PeterkalM/RollerBlinds/board/schematic.pdf

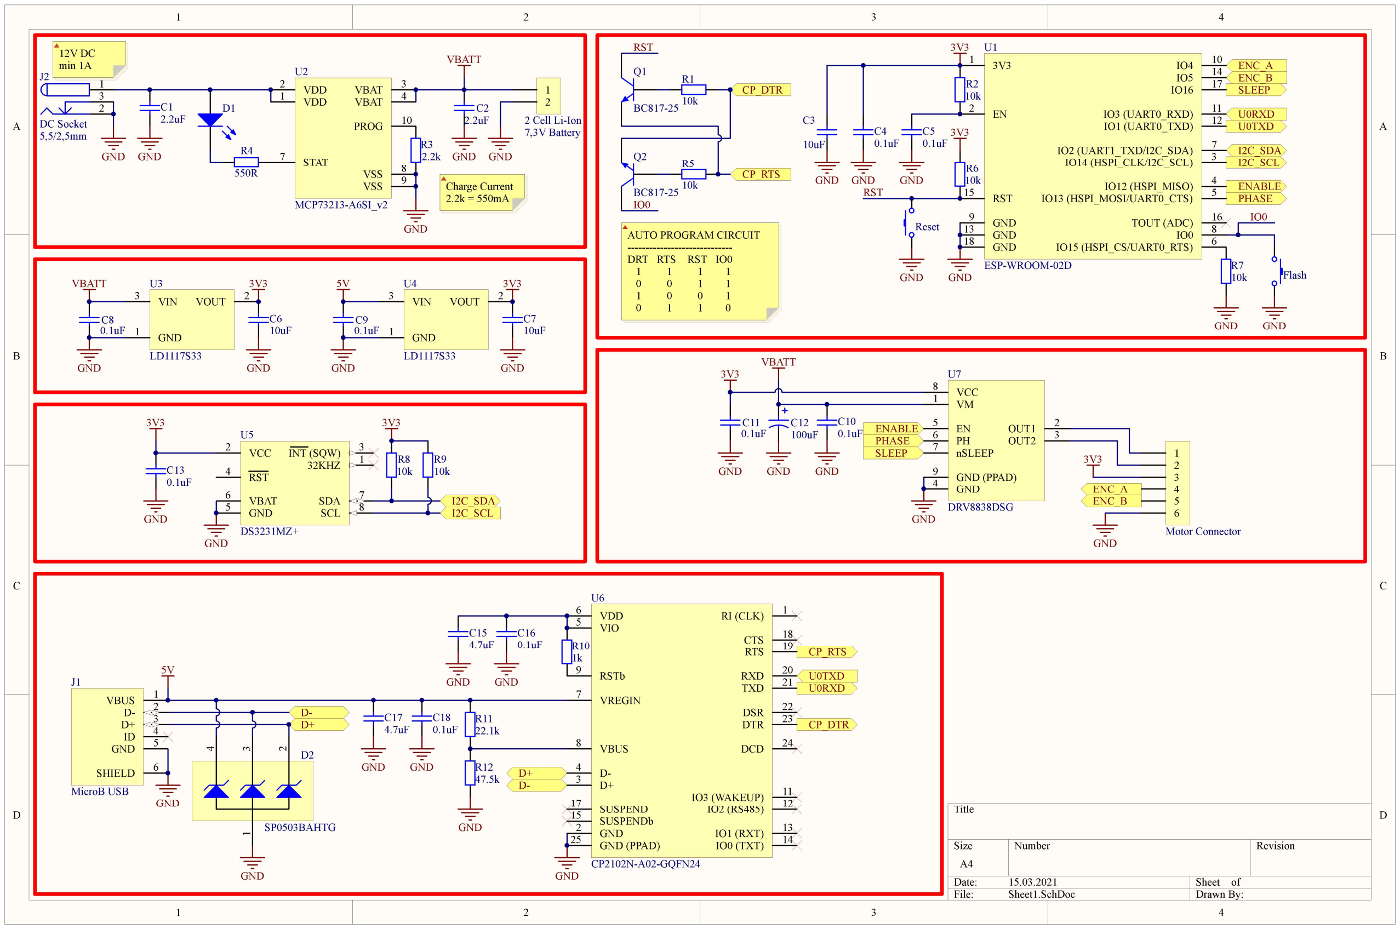
[picture p1: page 1]

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
Title

Size | Number | Revision
A4
Date: | 15.03.2021 | Sheet of
File: | Sheet1.SchDoc | Drawn By:

C3

10uF

C4
0.1uF

3V3

R2
10k

C5
0.1uF

GND

U0RXD
U0TXD

I2C_SDA
I2C_SCL

R7
10k

GND C8
0.1uF

C6
10uF

3V3

GND

C10
0.1uF ENABLE
PHASE
SLEEP | 3V3
| ENC_A
| ENC_B

GND

3V3

I2C_SDA
I2C_SCL

R9
10k

R8
10k

GND

3V3

ENABLE
PHASE

SLEEP

ENC_A
ENC_B

GND

C15
4.7uF

C16
0.1uF

GND

GND

GND

GND GND

GND GND

GND

GND | GND

GND

R10
1k

R11
22.1k

R12
47.5k

GND

D+
D-

C17
4.7uF

C18
0.1uF

GND GND

GND

D+

D-

GND

VBATT

CP_RTS

U0RXD

U0TXD

CP_DTR

R1

10k

R5

10k

3V3

VBATT

R6
10k

3V3

GND

5V

C9
0.1uF

C7
10uF

3V3

GND | GND

5V

C13
0.1uF
GND | R4
| 550R

C1
2.2uF

GND

C2
2.2uF

R3
2.2k

GND

GND GND

VBATT

1
2

7,3V Battery

### 2 Cell Li-Ion

CP_RTS

CP_DTR

32KHZ 1

VCC 2

INT (SQW) 3

RST 4

GND 5

VBAT 6 | SDA | 7
| SCL | 8

U5

DS3231MZ+

C11
0.1uF

GND

C12
100uF

D1

Flash

Reset

Q2

BC817-25

Q1

BC817-25

1
2
3
4
5
6
Motor Connector

IO0

RST

IO0

RST

VBUS | 1
D- | 2
D+ | 3
ID | 4
GND | 5
SHIELD | 6

J1

MicroB USB | 1

4

| 3

2
D2

SP0503BAHTG

VM 1

OUT1 | 2
OUT2 | 3

GND 4

EN 5
PH 6
nSLEEP 7

VCC 8

GND (PPAD) 9

U7

DRV8838DSG

VDD 2
VDD 1

STAT 7

VBAT | 3
VBAT | 4
PROG | 10
VSS | 8
VSS | 9

U2

MCP73213-A6SI_v2

RI (CLK) 1

GND 2

D+ 3

D- 4

VIO 5

VDD 6

VREGIN 7

VBUS 8

RSTb 9

IO3 (WAKEUP) | 11
IO2 (RS485) | 12
IO1 (RXT) | 13
IO0 (TXT) | 14

SUSPENDb 15

CTS | 18
RTS | 19
RXD | 20

SUSPEND 17

TXD | 21
DSR | 22
DTR | 23
DCD | 24

GND (PPAD) 25

U6

CP2102N-A02-GQFN24

3V3 1

EN 2

IO14 (HSPI_CLK/I2C_SCL) | 3
IO12 (HSPI_MISO) | 4
IO13 (HSPI_MOSI/UART0_CTS) | 5
IO15 (HSPI_CS/UART0_RTS) | 6
IO2 (UART1_TXD/I2C_SDA) | 7
IO0 | 8

GND 9

IO4 | 10
IO3 (UART0_RXD) | 11
IO1 (UART0_TXD) | 12

GND 13

IO5 14

RST 15

TOUT (ADC) | 16
IO16 | 17

GND 18

U1

ESP-WROOM-02D

1

2

3

5,5/2,5mm

J2

DC Socket

VOUT 2

GND 1

VIN 3

U3

LD1117S33

VOUT 2

GND 1

VIN 3

U4

LD1117S33

12V DC
min 1A

Charge Current
2.2k = 550mA

AUTO PROGRAM CIRCUIT
DRT RTS RST IO0
1 | 1 | 1 | 1
0 | 0 | 1 | 1
1 | 0 | 0 | 1
0 | 1 | 1 | 0
