PeterkalM/RollerBlinds/3D files/ruloo_assembly.SLDASM

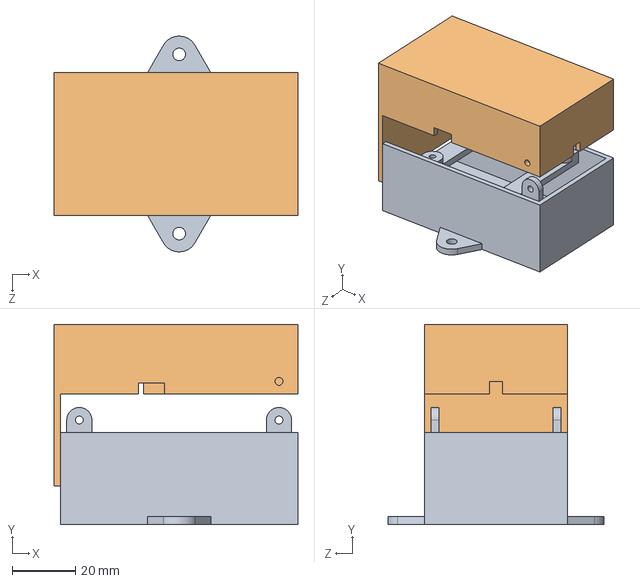
[picture p2: CAD file, 2021-03-15]
3D files/ruloo_assembly.SLDASM
77.0 x 63.2 x 68.1 mm
Karp
Kaas
