PeterkalM/RollerBlinds/3D files/micro-metal-gearmotor-bracket.step

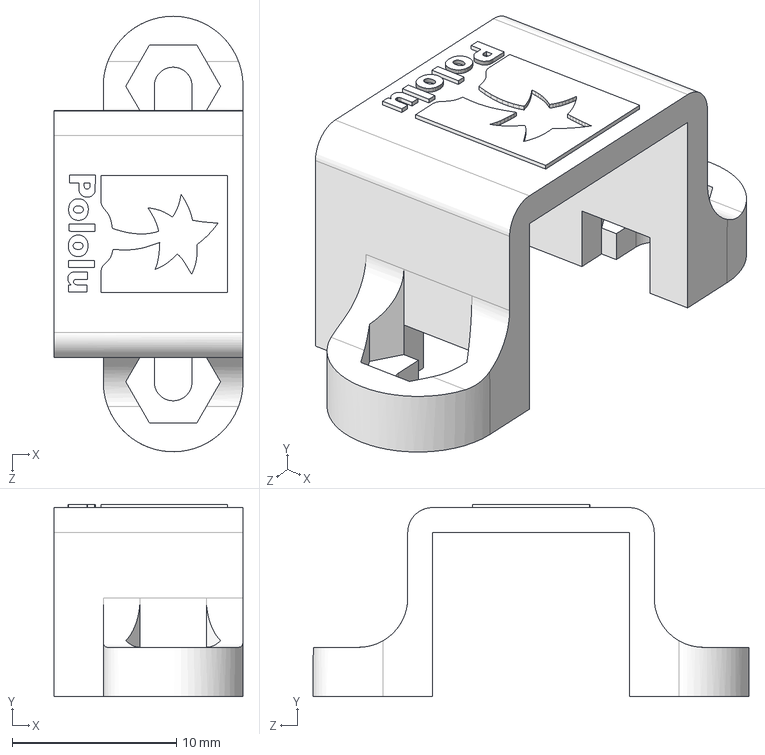
[picture p3: CAD file, 2021-03-15]
3D files/micro-metal-gearmotor-bracket.step
11.5 x 11.7 x 26.5 mm
