PeterkalM/RollerBlinds/3D files/ruloo_spinner.SLDPRT

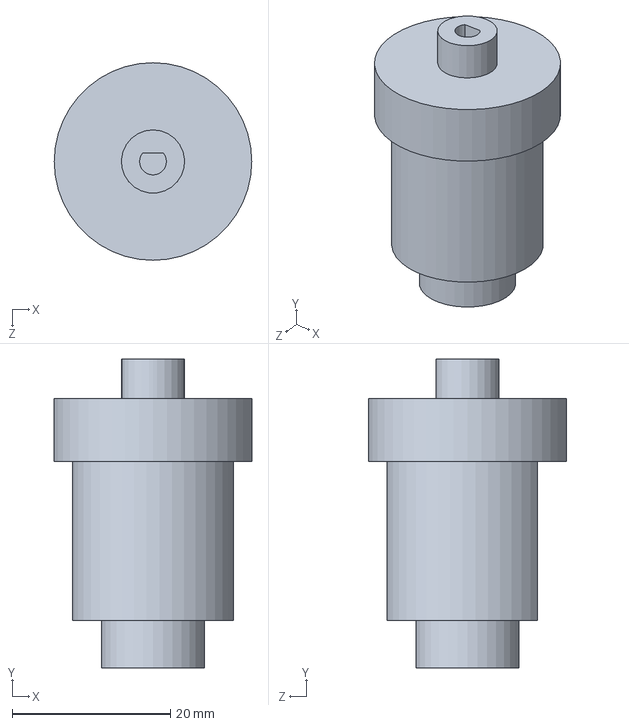
[picture p4: CAD file, 2021-03-15]
3D files/ruloo_spinner.SLDPRT
25.0 x 39.1 x 25.0 mm
