PeterkalM/RollerBlinds/3D files/ruloo_lid.SLDPRT

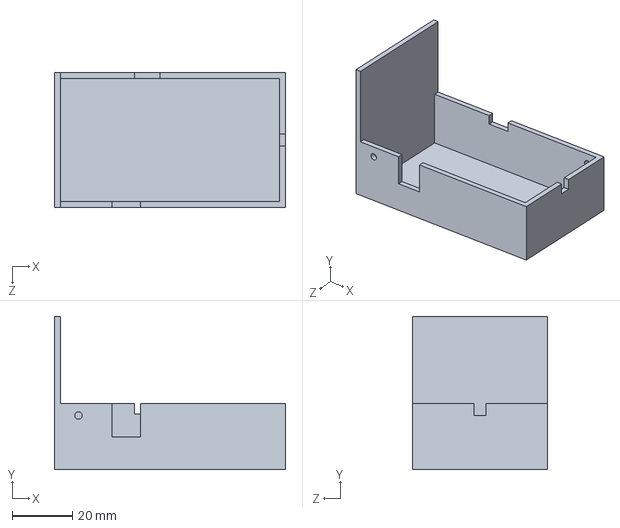
[picture p5: CAD file, 2021-03-15]
3D files/ruloo_lid.SLDPRT
77.0 x 51.0 x 45.0 mm
