PeterkalM/RollerBlinds/3D files/ruloo_motor_holder.SLDPRT

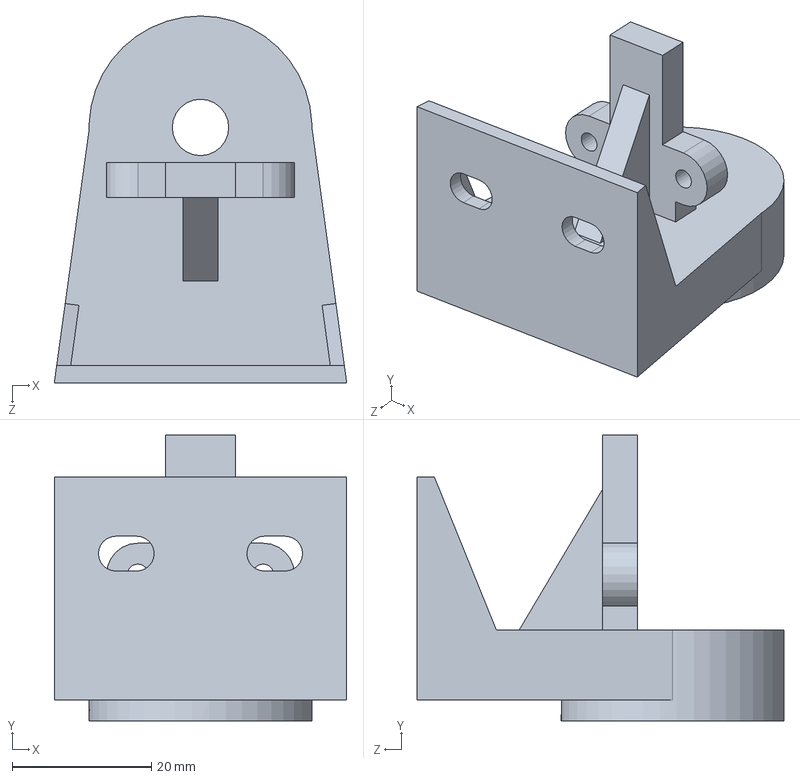
[picture p6: CAD file, 2021-03-15]
3D files/ruloo_motor_holder.SLDPRT
42.0 x 41.0 x 52.7 mm
