PeterkalM/RollerBlinds/3D files/ruloo_case.SLDPRT

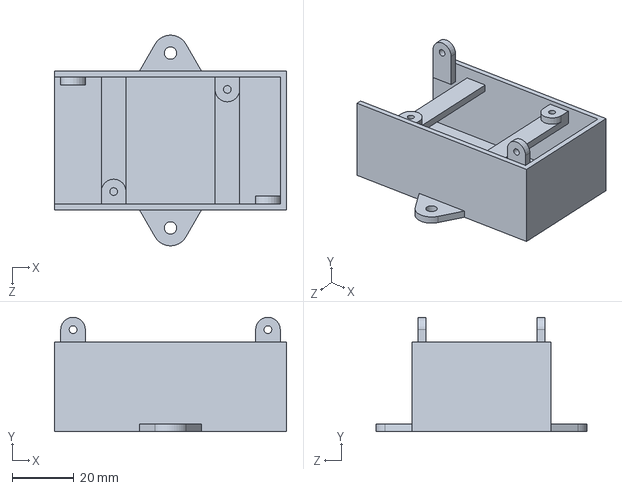
[picture p7: CAD file, 2021-03-15]
3D files/ruloo_case.SLDPRT
75.0 x 37.0 x 68.1 mm
