PeterkalM/RollerBlinds/(list of files, cad)

Other CAD files:
3D files/ruloo_case.STL
3D files/ruloo_lid.STL
3D files/ruloo_motor_holder.STL
3D files/ruloo_spinner.STL
